Stella-CN/NavBot/docs/README.md

# NavBot 设计文档

更新日期：2026-10-19。已完成资料分析、设计草案及 [navbot_body 工程模板](../deps/navbot_body/README.md)与静态审查；电机闭环、串口协议和 ROS 2 功能尚未实现，未执行固件编译、下载或实机验证。

| 文档 | 内容 |
| --- | --- |
| [C30D硬件分析](c30d-hardware-analysis.md) | 引脚、电机控制、IMU数据流程、证据来源与参数状态 |
| [Jetson与C30D通信协议草案](jetson-c30d-protocol.md) | 系统职责、帧结构、消息内容、时间同步与失效处理 |
| [实施与验证计划](implementation-plan.md) | 技术栈、阶段交付、实测参数清单与验收条件 |

## 参数状态约定

- **用户确认**：用户提供的实车配置；不等于已读取设备或完成测试。
- **资料确认**：原理图或示例源码中已核对；仍需确认实物版本和接线匹配。
- **设计建议**：本项目拟采用的方案，尚未冻结或验证。
- **待实测**：需要在实物或运行系统上测量、读取或标定。
- **待定**：需要在编码前明确的设计细节。

协议 v0.1 为讨论草案，不能作为已经冻结的逐字节实现规范。后续修改应同时维护参数状态和来源。
