Stella-CN/NavBot/docs/implementation-plan.md

# NavBot实施与验证计划

日期：2026-10-19。状态：已完成 navbot_body 工程模板和静态审查，其余功能处于规划阶段。当前授权范围止于模板生成、静态验证及仓库管理，未执行编译、下载或运动测试。

## 1 技术栈与范围

| 层级 | 拟采用技术 | 状态 |
| --- | --- | --- |
| MCU | STM32F407、C、定时器编码器/PWM、UART DMA、ICM20948驱动 | 设计建议 |
| MCU工程框架 | STM32 HAL、CubeF4 V1.28.3、C11、CMake + GCC、VS Code、CMSIS-DAP/OpenOCD | 模板已生成并静态审查；未编译或实测 |
| 调度 | FreeRTOS V10.3.1 / CMSIS-RTOS2，控制、通信、采集、监控四任务 | 静态任务骨架已建立；业务功能和实时性待验证 |
| Jetson | Orin Nano、JetPack 7.2.1、ROS 2 Jazzy | 硬件来自仓库；版本用户确认，待读取设备核对 |
| 主机实现 | C++串口驱动节点、ament/colcon、参数配置 | 设计建议 |
| 定位导航 | robot_localization、SLAM Toolbox或AMCL、Nav2 | 设计建议；具体依赖版本待锁定 |
| 感知 | N10激光雷达、D435深度相机 | 仓库目标架构；实机接口待核对 |

初期由自定义串口节点发布轮式里程计和IMU；不同时叠加另一套运动学控制器。若以后采用ros2_control，应重新明确运动学和TF所有权。

## 2 已确认与待实测参数

| 参数 | 当前状态 | 确认方法 / 输出记录 |
| --- | --- | --- |
| 普通轮四驱差速、MG513 GMR、USB | 用户确认 | 作为方案输入 |
| 新版C30D | 用户确认 | 待读取丝印、记录版本 |
| IMU为ICM20948 | 新版资料确认 | 读取WHO_AM_I、验证通信与轴向 |
| 电机PWM/编码器引脚 | 资料确认 | 与实板、通道接线逐项核对 |
| USB串口3 | 设计建议 | 枚举、稳定身份、拔插与供电测试 |
| 460800/8N1 | 设计建议 | 双向持续传输、错误计数和延迟统计 |
| MG513完整型号及减速比 | 待确认 | 铭牌、订单或厂家规格 |
| 每轮输出轴有效计数 | 待实测 | 标记车轮，多圈正反转计数，核验倍率 |
| A/B/C/D到四轮映射 | 待实测 | 架空单轮点动和手动转轮记录 |
| 电机/编码器符号 | 待实测 | 四轮前进方向均为正，确认闭环负反馈 |
| 实际轮径、左右差异 | 待实测 | 负载下滚动距离标定；85mm模型仅作线索 |
| 几何轮距、轴距 | 待实测 | 装配测量 |
| 有效轮距b_eff | 待标定 | 正反向旋转、多圈、不同地面/载荷验证 |
| 最大轮速与加减速度 | 待实测 | 负载测试、停车距离与驱动能力评估 |
| PI参数 | 待整定 | 各轮阶跃、低速、正反转、负载变化 |
| 电池规格与阈值 | 待确认/实测 | 化学体系、串数、BMS阈值、电压校准及迟滞 |
| IMU外参、偏置和噪声 | 待标定 | 静置、六面、受控旋转和温度变化 |
| 100Hz控制、100Hz反馈 | 设计建议 | 测量真实周期、抖动、传感器新鲜度 |
| 200ms失联阈值 | 设计建议 | 结合最大速度和停车距离确认 |
| 硬件急停/断能路径 | 待确认 | 检查电源链路；PD3仅软件输入 |
| JetPack/ROS版本和内核驱动 | 用户提供，待读取核对 | 软件包版本、系统版本、CH9102枚举 |

所有标定记录应包含日期、板卡/电机标识、固件版本、配置摘要、地面、载荷、测量方法、结果和误差。尚无测量值的单元不得填入示例默认值。

## 3 分阶段实施

### 阶段一 硬件与环境基线

确认板卡、IMU、电机参数、USB端口、供电和轮子接线；读取Jetson环境。明确轮径、计数、方向和电池安全范围。

交付：接线表、参数表、环境清单、测量记录。

验收：每个物理通道可追踪到对应车轮；每轮计数与方向已确认；电源和禁止运动路径明确。

### 阶段二 协议冻结

完成[协议草案](jetson-c30d-protocol.md)第8节待定项；冻结全部消息布局、状态迁移、超时、时间同步、重连和错误处理。MCU框架已选择HAL、CMake/GCC与FreeRTOS，仍需验证工具链和运行行为。

交付：协议v1.0、参数模式、消息黄金样本、状态迁移表、量化测试阈值。

验收：不存在“由实现自行决定”的端序、单位、长度、状态或时效语义；两端可独立按规范实现。

### 阶段三 MCU基础控制

从经过核对的驱动建立最小工程；实现四路编码器、100Hz闭环、IMU、电压、单调时钟、看门狗和安全状态机。按实车整定，删除不使用的巡线、蓝牙抢占和车型切换路径。

交付：固件、参数配置、控制周期和轮速测试记录。

验收：架空方向正确；采集失败不阻塞控制；禁止/故障不会保留旧PI输出；控制周期和执行时间满足冻结指标。

### 阶段四 两端通信

实现定宽编解码、CRC、DMA收发、固定容量队列、握手与会话、时间同步、ACK和诊断。Jetson串口资源采用RAII管理，支持有界退出和重连。

数据所有权：DMA只写接收缓冲，解析器消费完整帧，控制任务拥有执行目标和PI状态；遥测读取一致快照。配置通过明确事务切换，不能在控制中途改变多个相关参数。实时路径避免动态分配和阻塞I/O。

交付：两端通信、黄金向量测试、错误注入记录。

验收：拆包、粘包、CRC错、超长、未知ID、序号回绕、旧会话、延迟命令、USB断连、MCU重启均符合协议；无越界和无界缓存增长。

### 阶段五 ROS与标定

发布轮式里程计、IMU和诊断；完成采样时间到ROS时间映射。建立URDF固定外参，配置EKF，验证唯一TF发布者。标定轮径、有效轮距、IMU偏置与协方差。

交付：ROS包、启动与参数文件、标定记录、rosbag。

验收：前进vx为正，左转wz为正；计数重启不造成位姿突跳；同源数据不被当作独立观测重复融合；直行、旋转误差满足冻结阈值。

### 阶段六 导航与故障联调

接入激光定位和Nav2，先低速、再逐级验证目标运行范围。D435与N10直接接入Jetson，其数据不通过底盘串口转发。

交付：导航配置、运行手册、故障矩阵与持续运行报告。

验收：停止上游cmd_vel、终止串口节点、拔USB、MCU复位、IMU异常、欠压等场景均按规定停车或禁止；恢复后不自动继续旧运动。记录停车时间和距离，不能仅以“PWM已清零”作为验收。

## 4 测试原则

- 先架空单轮，再架空闭环，最后落地低速；运动测试需在实施阶段另行安排。
- 根据实测冻结控制抖动、通信延迟、同步误差、里程计误差和停车距离阈值，不宣称当前已达标。
- 测试覆盖输入边界与失效行为，不只测试正常报文和直线行驶。
- 软件STOP、驱动制动与硬件断能分别验证。
- 未验证的电流、荷电百分比、绝对航向等不作为功能交付。

当前交付包含本组设计文档及 [navbot_body 工程模板](../deps/navbot_body/README.md)，通过 submodule 管理。模板仅完成静态审查，未编译或下载；未实现闭环、ROS节点或可执行协议。
