Stella-CN/NavBot/hardware/5寸屏幕-2D-B/2D.png

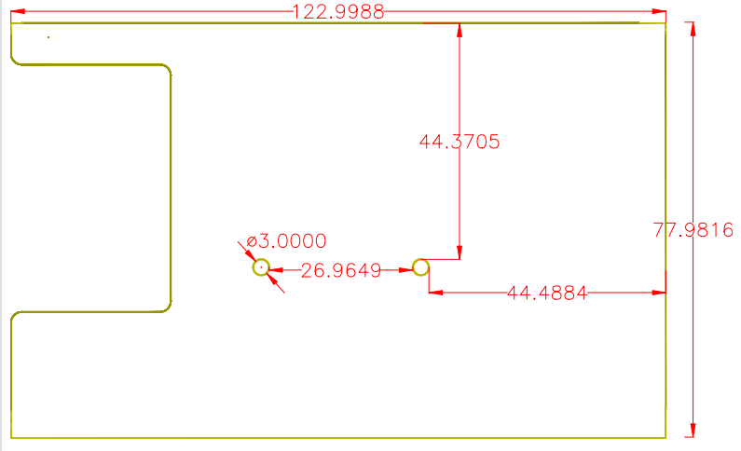
hardware/5寸屏幕-2D-B/2D.png
