Stella-CN/NavBot/hardware/12v-19v变压器图纸.png

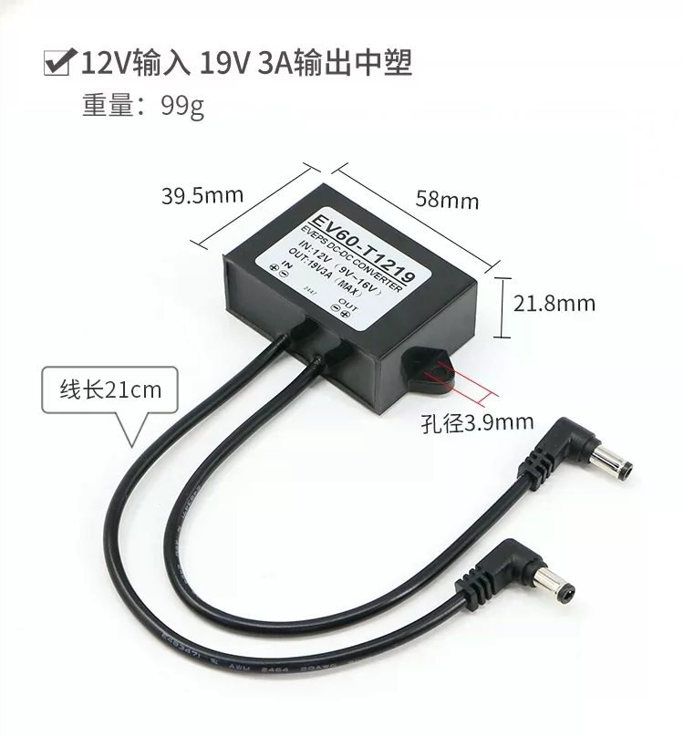
hardware/12v-19v变压器图纸.png
