Stella-CN/NavBot/hardware/开关图纸.png

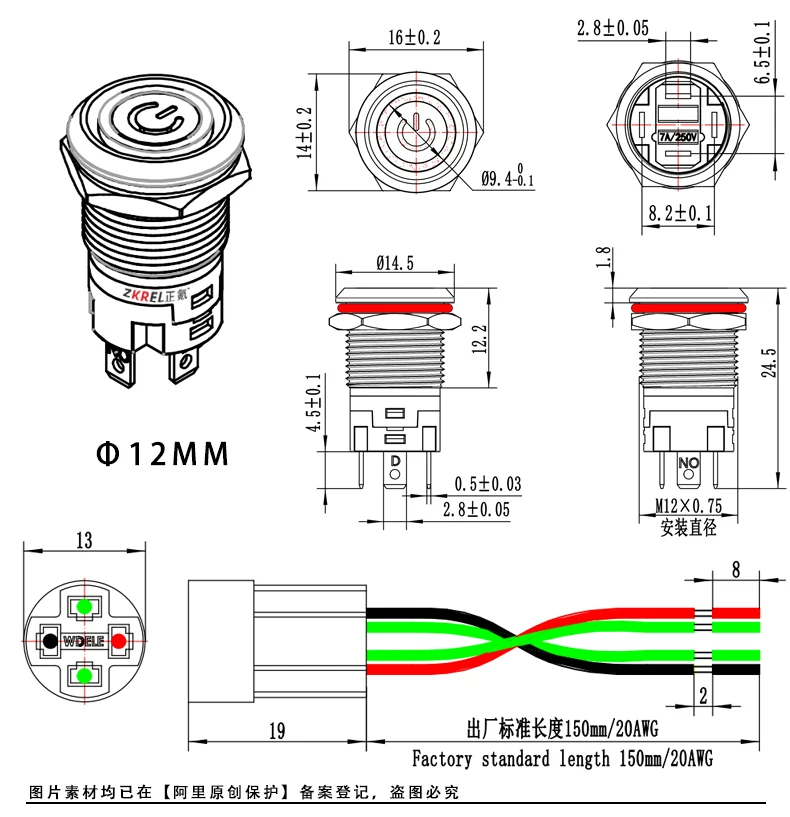
hardware/开关图纸.png
