Stella-CN/NavBot/hardware/design-v13/打印件清单.csv

编号 | 名称 | 数量 | CAD对象 | STL
01 | 承重底板（直连金属支架） | 1 | ChassisLower | prototype-stl/ChassisLower.stl
02 | 整体罩壳＋颈部过渡 | 1 | ChassisLid | prototype-stl/ChassisLid.stl
03 | 后抽充电座＋线夹鞍座 | 1 | ChargePort_Insert_D12_placeholder | prototype-stl/ChargePort_Insert_D12_placeholder.stl
04 | 双螺丝鞍式线夹压盖 | 1 | ChargeCableClampCap | prototype-stl/ChargeCableClampCap.stl
05 | 上压架＋C30D 安装台＋M3螺母耳 | 1 | C30D_RemovableTray | prototype-stl/C30D_RemovableTray.stl
06 | 升压模块四点框架 | 1 | DCDC_RemovableTray | prototype-stl/DCDC_RemovableTray.stl
07 | 头部前壳＋面板＋屏幕/相机托架 | 1 | HeadFront | prototype-stl/HeadFront.stl
08 | 曲面主壳＋N10齐平安装面及穿线孔 | 1 | HeadRear | prototype-stl/HeadRear.stl
09 | Jetson 可拆托盘 | 1 | Jetson_RemovableTray | prototype-stl/Jetson_RemovableTray.stl
10 | 电池下托＋共用安装耳 | 1 | BatteryTray_strap_slots | prototype-stl/BatteryTray_strap_slots.stl
