Stella-CN/NavBot/hardware/5寸屏幕-2D-B/GKHD5.0-2D.dxf

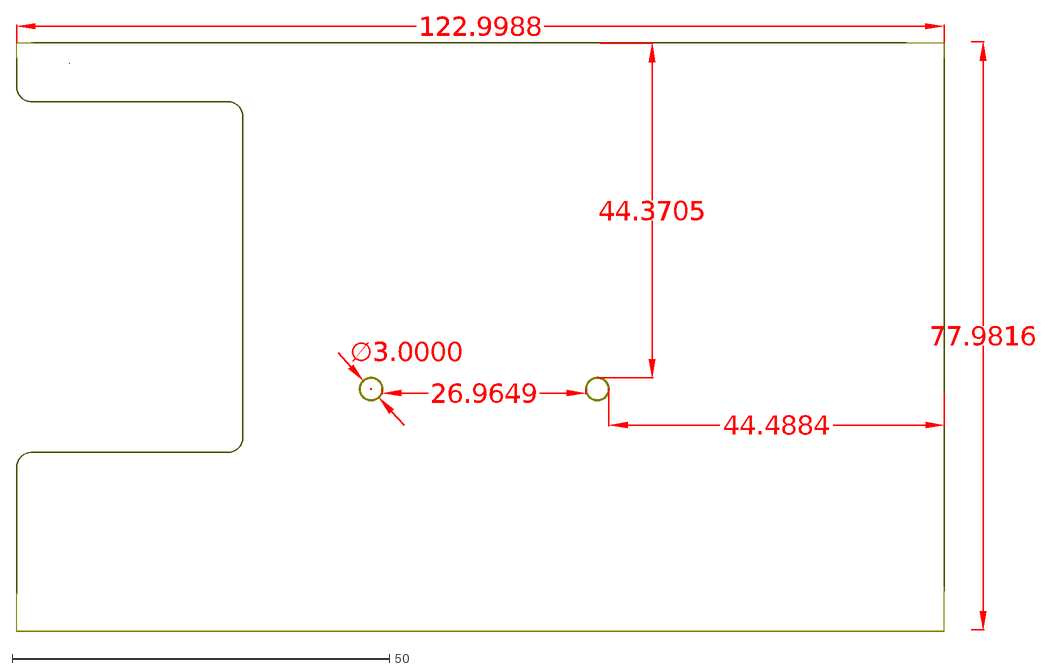
[picture p6: CAD file, 2026-10-19]
hardware/5寸屏幕-2D-B/GKHD5.0-2D.dxf
122.9988
77.9816
44.4884
44.3705
26.9649
∅3.0000
