Stella-CN/NavBot/hardware/Depth-Cameras/D456_Solid.SLDPRT

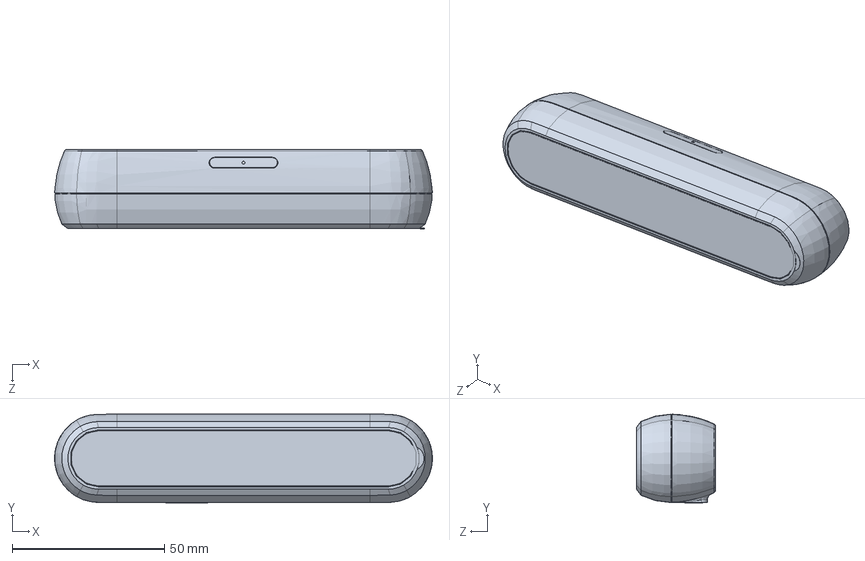
[picture p7: CAD file, 2026-10-19]
hardware/Depth-Cameras/D456_Solid.SLDPRT
124.0 x 29.1 x 26.0 mm
