Stella-CN/NavBot/hardware/design-v13/NavBot-V13-Print-Pack/STEP/10_BatteryTray_strap_slots.step

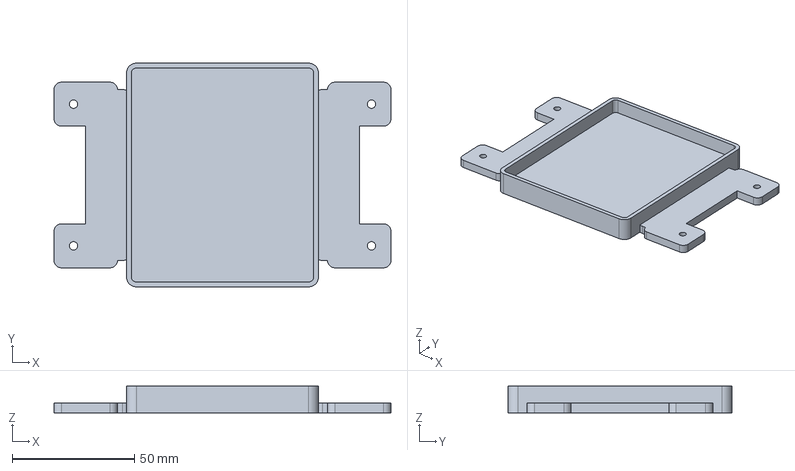
[picture p8: CAD file, 2026-10-19]
hardware/design-v13/NavBot-V13-Print-Pack/STEP/10_BatteryTray_strap_slots.step
138.0 x 91.6 x 11.0 mm
