Stella-CN/NavBot/hardware/design-v13/prototype-stl/ChassisLid.stl

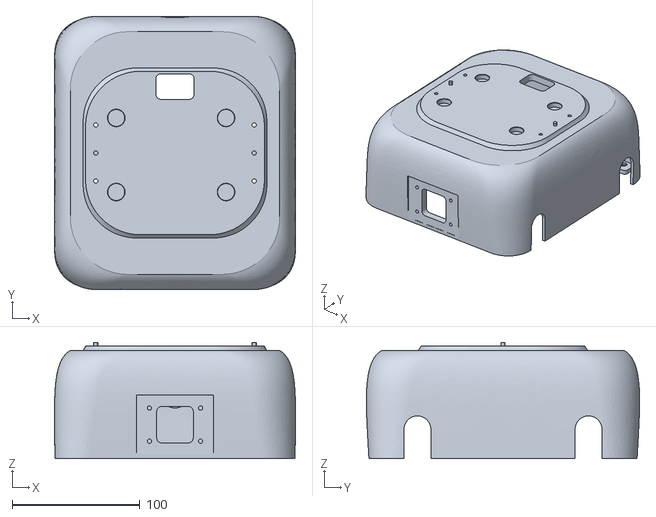
[picture p9: CAD file, 2026-10-19]
hardware/design-v13/prototype-stl/ChassisLid.stl
188.7 x 214.0 x 91.2
