Stella-CN/NavBot/hardware/STM32主控-C10B（两驱差速车使用）.stp

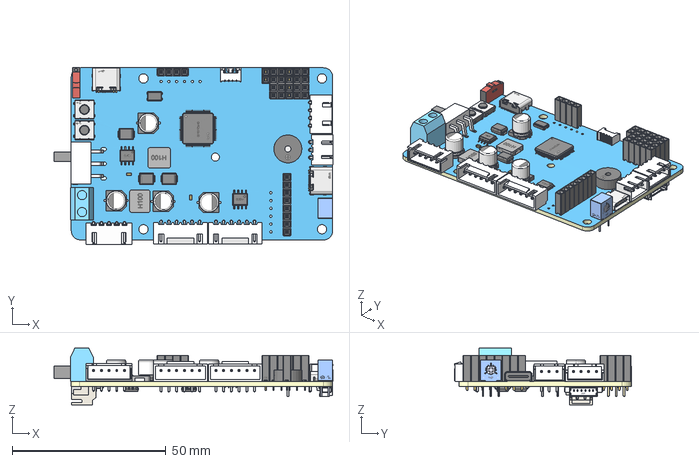
[picture p10: CAD file, 2026-10-19]
hardware/STM32主控-C10B（两驱差速车使用）.stp
90.7 x 57.6 x 18.5 mm
