Stella-CN/NavBot/hardware/Depth-Cameras/D435_Solid.SLDPRT

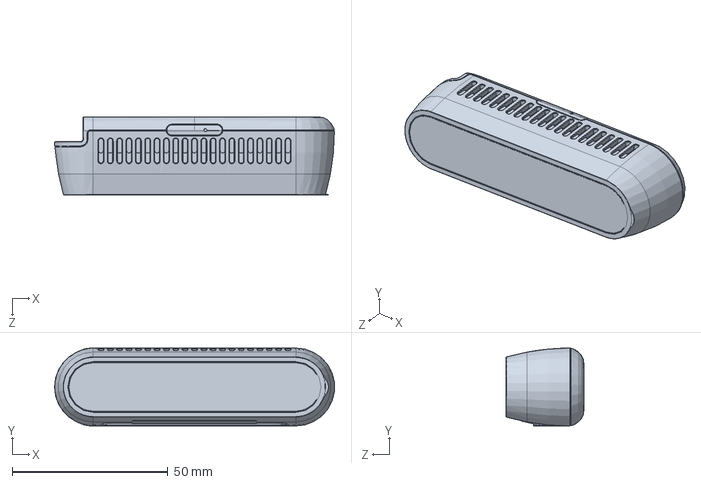
[picture p11: CAD file, 2026-10-19]
hardware/Depth-Cameras/D435_Solid.SLDPRT
89.8 x 25.0 x 25.1 mm
