Stella-CN/NavBot/hardware/design-v13/NavBot-V13-Print-Pack/STEP/03_ChargePort_Insert_D12_placeholder.step

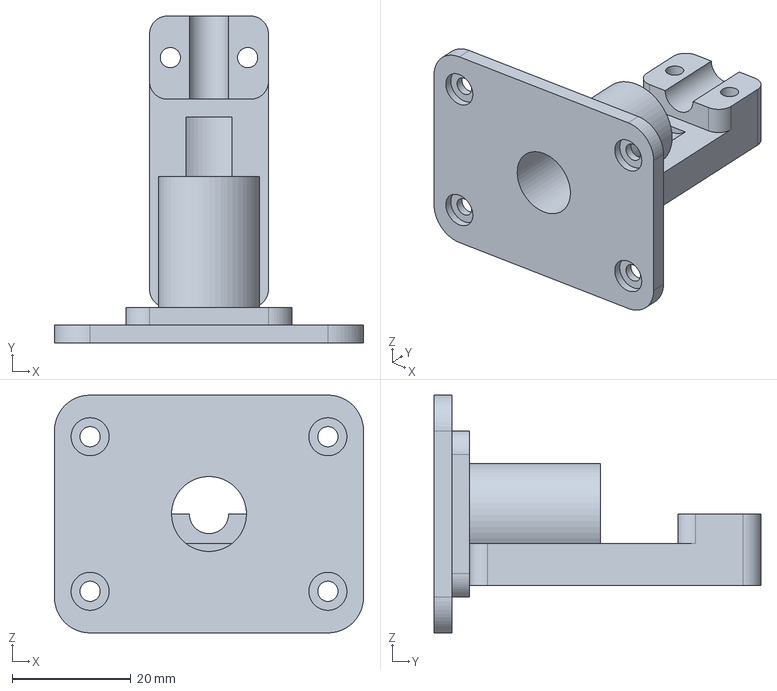
[picture p12: CAD file, 2026-10-19]
hardware/design-v13/NavBot-V13-Print-Pack/STEP/03_ChargePort_Insert_D12_placeholder.step
52.0 x 55.0 x 40.0 mm
