Stella-CN/NavBot/hardware/design-v13/prototype-stl/HeadFront.stl

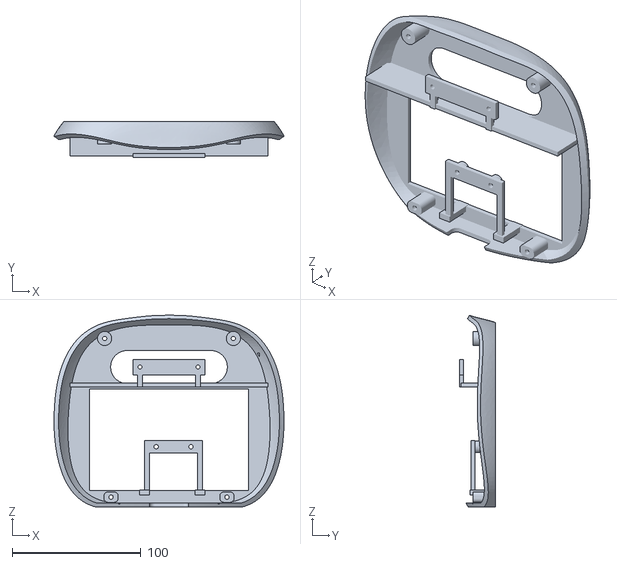
[picture p13: CAD file, 2026-10-19]
hardware/design-v13/prototype-stl/HeadFront.stl
178.6 x 28.0 x 148.7
