Stella-CN/NavBot/hardware/雷达_雷神N10.stp

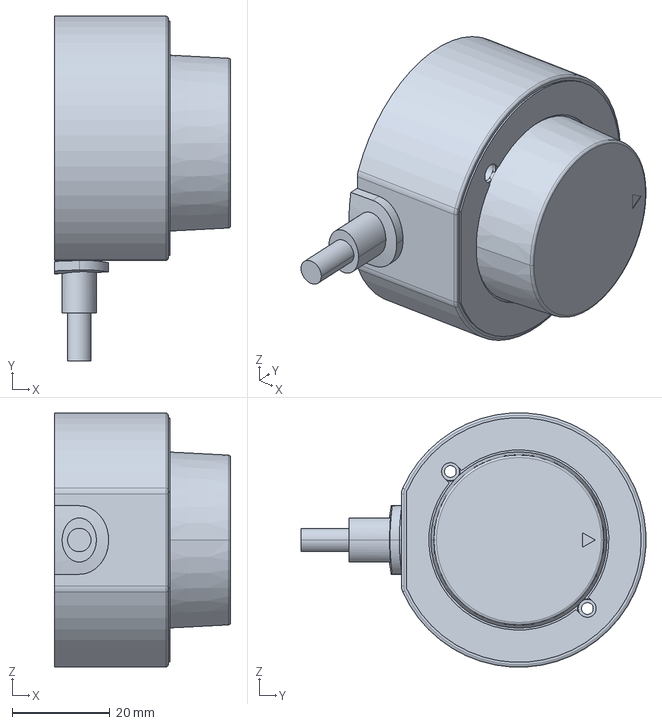
[picture p14: CAD file, 2026-10-19]
hardware/雷达_雷神N10.stp
36.1 x 70.5 x 51.9 mm
