Stella-CN/NavBot/hardware/design-v13/NavBot-V13-Print-Pack/STEP/09_Jetson_RemovableTray.step

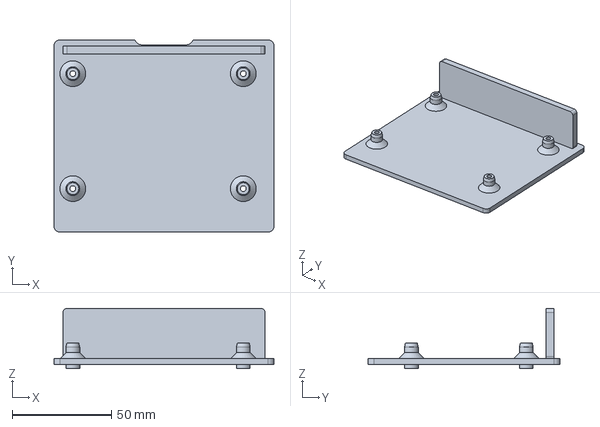
[picture p15: CAD file, 2026-10-19]
hardware/design-v13/NavBot-V13-Print-Pack/STEP/09_Jetson_RemovableTray.step
111.0 x 97.0 x 30.3 mm
