Stella-CN/NavBot/hardware/design-v13/prototype-stl/HeadRear.stl

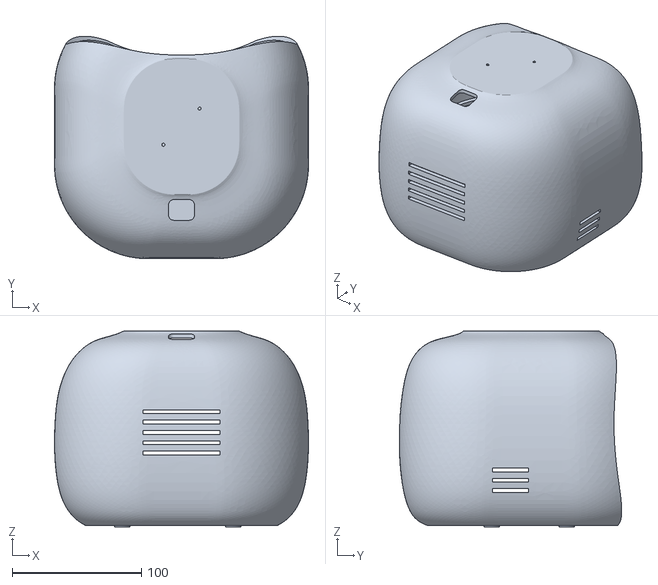
[picture p16: CAD file, 2026-10-19]
hardware/design-v13/prototype-stl/HeadRear.stl
196.7 x 172.3 x 151.7
