Stella-CN/NavBot/hardware/E351S电池(客户图）.stp

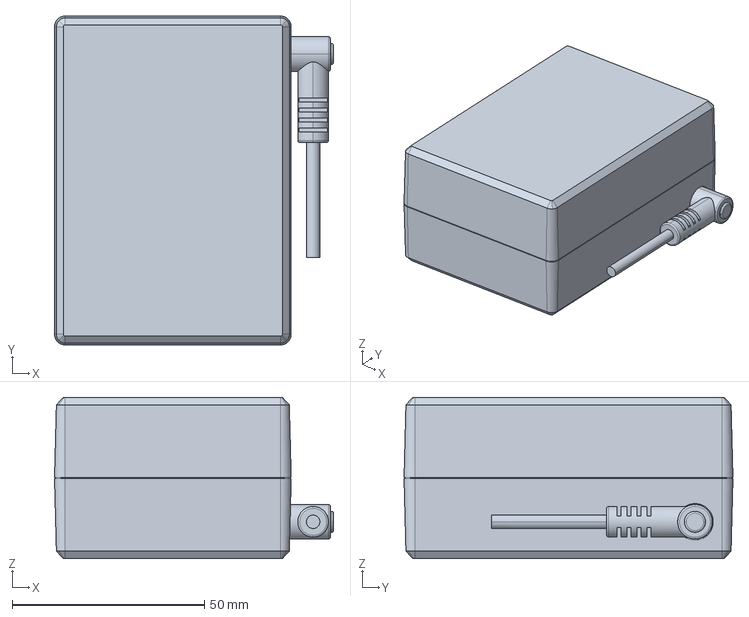
[picture p17: CAD file, 2026-10-19]
hardware/E351S电池(客户图）.stp
72.6 x 85.6 x 42.0 mm
