Stella-CN/NavBot/hardware/design-v13/NavBot-V13-Print-Pack/STEP/05_C30D_RemovableTray.step

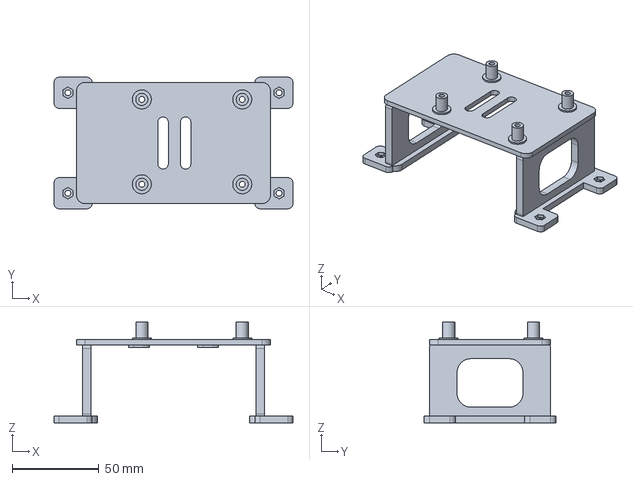
[picture p18: CAD file, 2026-10-19]
hardware/design-v13/NavBot-V13-Print-Pack/STEP/05_C30D_RemovableTray.step
138.0 x 76.0 x 58.1 mm
