Stella-CN/NavBot/hardware/轴直径6mm_六角联轴器.stp

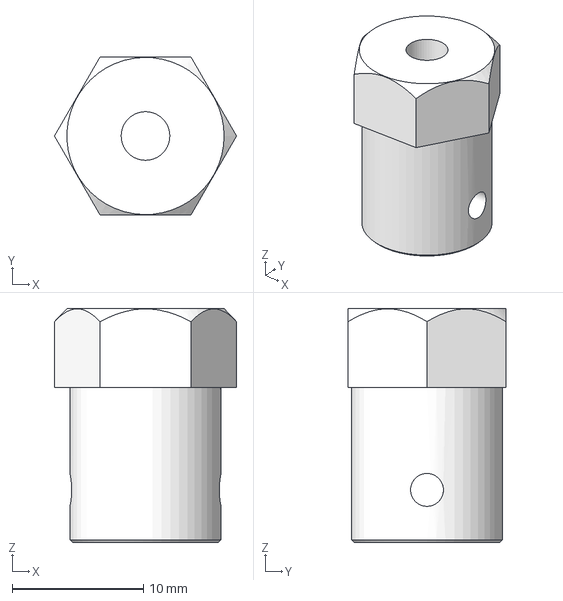
[picture p19: CAD file, 2026-10-19]
hardware/轴直径6mm_六角联轴器.stp
13.9 x 12.0 x 17.8 mm
