Stella-CN/NavBot/hardware/Depth-Cameras/D415_Solid.SLDPRT

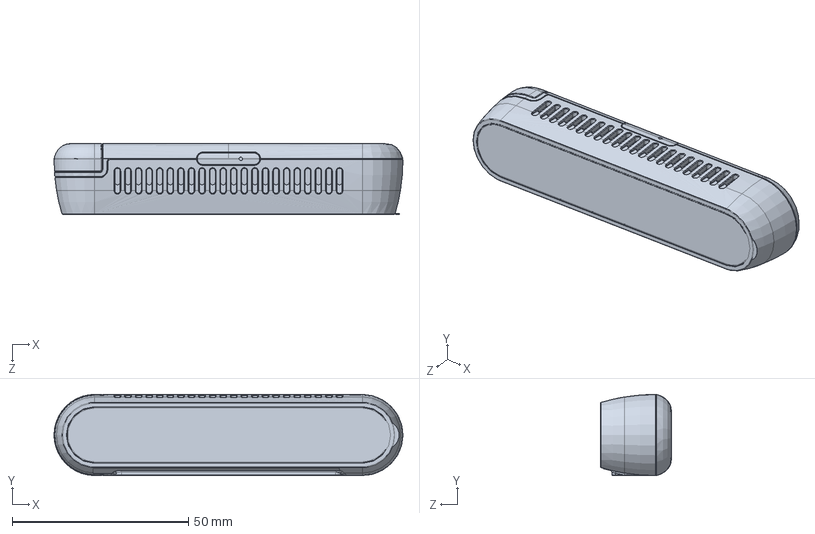
[picture p20: CAD file, 2026-10-19]
hardware/Depth-Cameras/D415_Solid.SLDPRT
99.0 x 23.0 x 20.1 mm
