Stella-CN/NavBot/hardware/design-v13/prototype-stl/DCDC_RemovableTray.stl

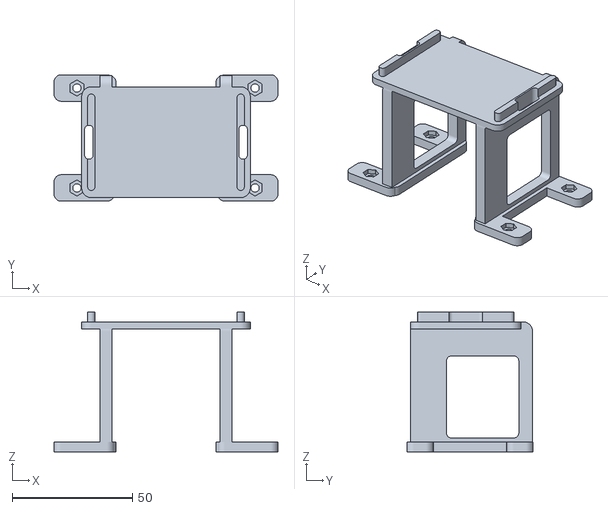
[picture p21: CAD file, 2026-10-19]
hardware/design-v13/prototype-stl/DCDC_RemovableTray.stl
93.0 x 52.5 x 58.0
