Stella-CN/NavBot/hardware/STM32主控-C30D（小车使用）.stp

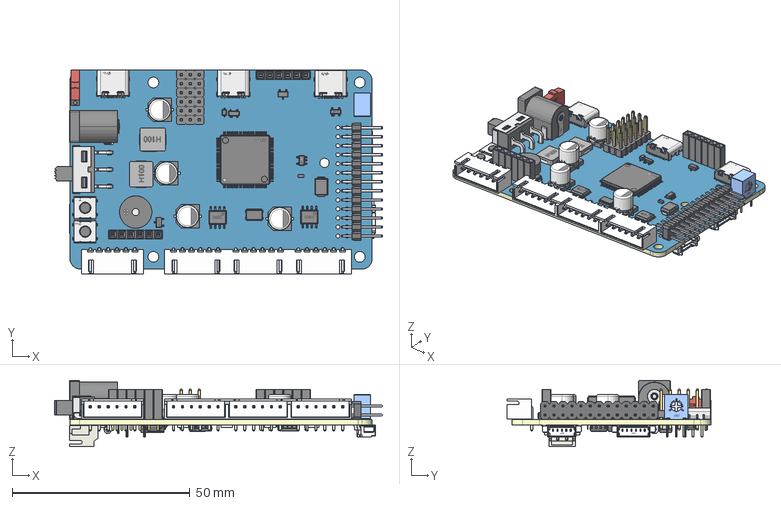
[picture p22: CAD file, 2026-10-19]
hardware/STM32主控-C30D（小车使用）.stp
92.2 x 57.5 x 18.7 mm
