Stella-CN/NavBot/hardware/Depth-Cameras/D405_Solid.SLDPRT

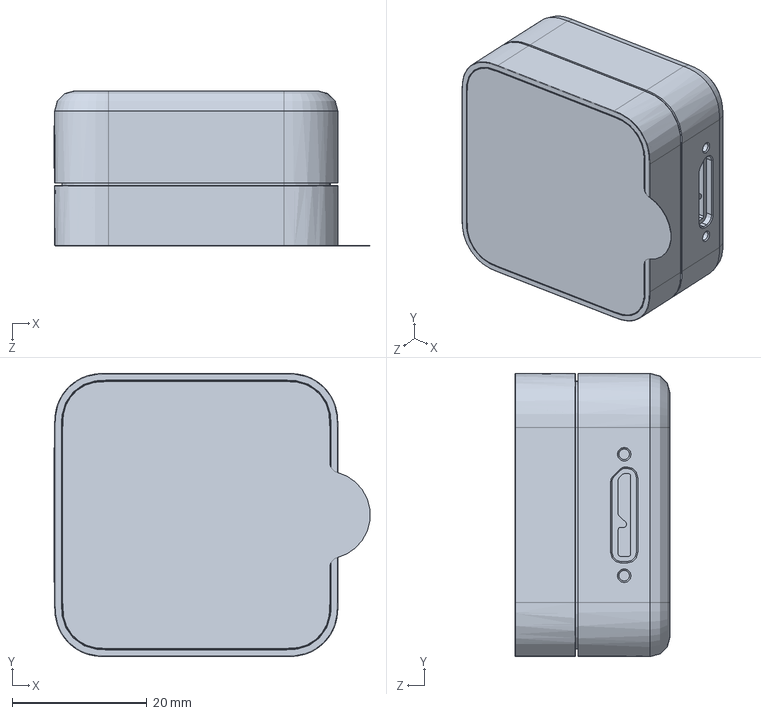
[picture p23: CAD file, 2026-10-19]
hardware/Depth-Cameras/D405_Solid.SLDPRT
46.8 x 42.0 x 23.0 mm
