Stella-CN/NavBot/hardware/design-v13/NavBot-V13-Print-Pack/STEP/04_ChargeCableClampCap.step

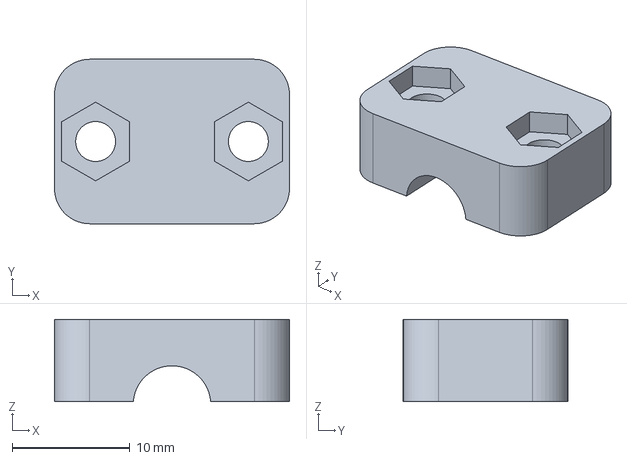
[picture p24: CAD file, 2026-10-19]
hardware/design-v13/NavBot-V13-Print-Pack/STEP/04_ChargeCableClampCap.step
20.0 x 14.0 x 7.00 mm
