Stella-CN/NavBot/hardware/design-v13/prototype-stl/ChassisLower.stl

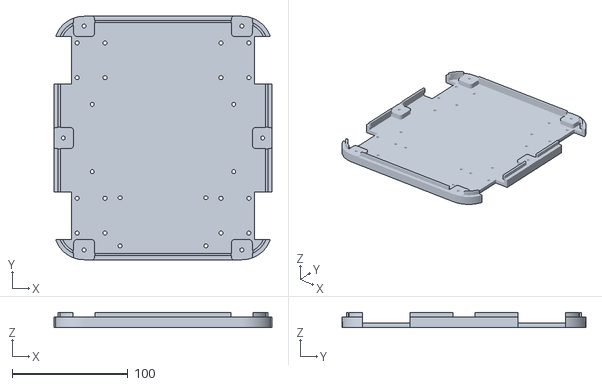
[picture p25: CAD file, 2026-10-19]
hardware/design-v13/prototype-stl/ChassisLower.stl
188.0 x 210.0 x 13.0
