Stella-CN/NavBot/hardware/电机支架_MG513电机支架(37支架）.stp

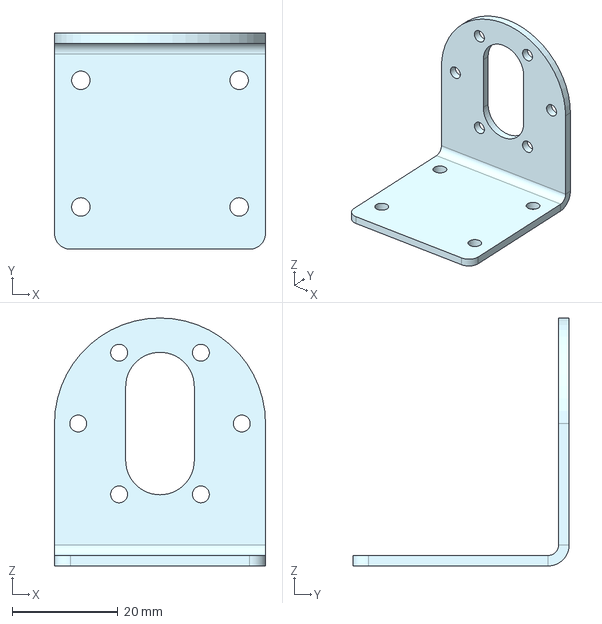
[picture p26: CAD file, 2026-10-19]
hardware/电机支架_MG513电机支架(37支架）.stp
40.0 x 41.0 x 47.0 mm
