Stella-CN/NavBot/hardware/Depth-Cameras/D455f_Solid.SLDPRT

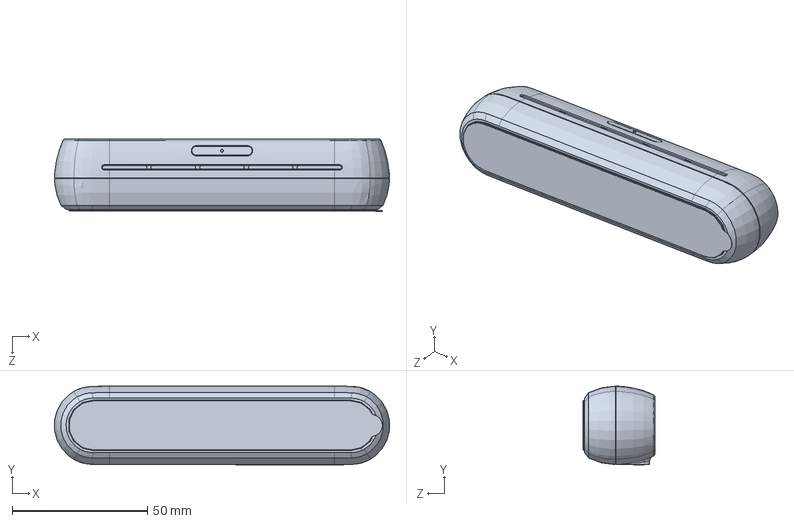
[picture p27: CAD file, 2026-10-19]
hardware/Depth-Cameras/D455f_Solid.SLDPRT
123.8 x 29.1 x 26.6 mm
