Stella-CN/NavBot/hardware/直流电机_MG513P10-12V(GMR）.stp

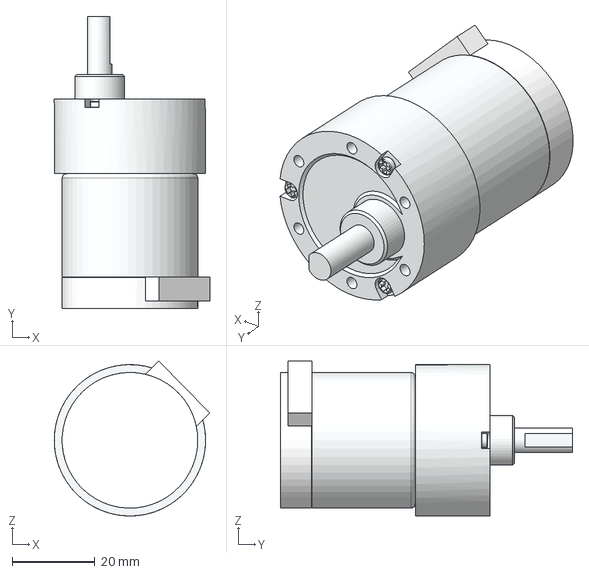
[picture p28: CAD file, 2026-10-19]
hardware/直流电机_MG513P10-12V(GMR）.stp
37.6 x 70.6 x 37.5 mm
