Stella-CN/NavBot/hardware/Depth-Cameras/D435f_Solid.SLDPRT

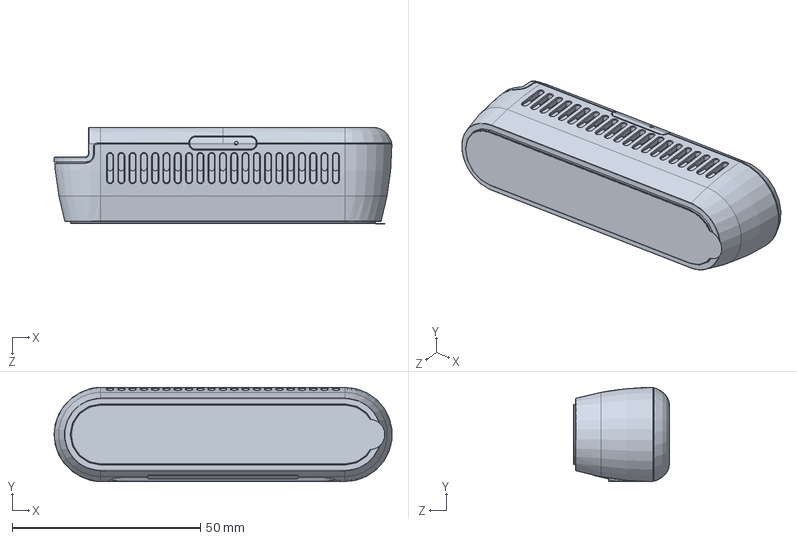
[picture p29: CAD file, 2026-10-19]
hardware/Depth-Cameras/D435f_Solid.SLDPRT
89.8 x 25.0 x 25.6 mm
