Stella-CN/NavBot/hardware/Depth-Cameras/D457_Solid.SLDPRT

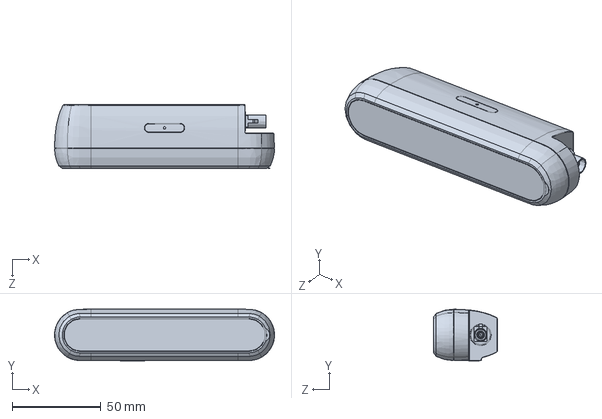
[picture p30: CAD file, 2026-10-19]
hardware/Depth-Cameras/D457_Solid.SLDPRT
124.0 x 29.1 x 36.0 mm
