Stella-CN/NavBot/hardware/智能车轮_直径85mm.stp

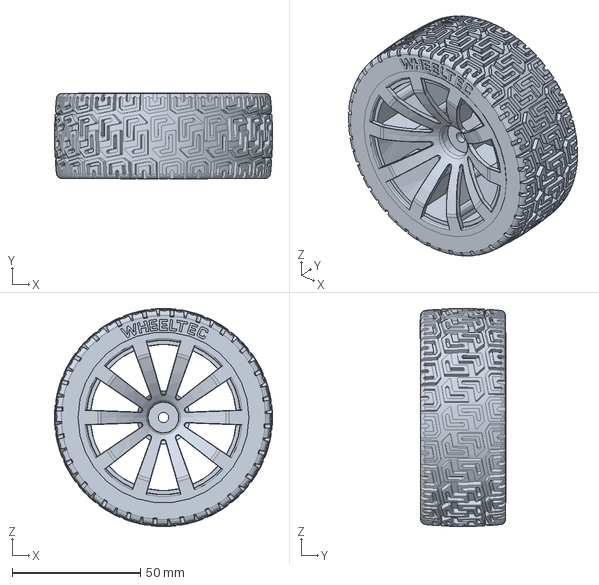
[picture p31: CAD file, 2026-10-19]
hardware/智能车轮_直径85mm.stp
85.0 x 33.4 x 85.0 mm
