Stella-CN/NavBot/(list of files, cad)

Other CAD files:
hardware/design-v13/NavBot-V13.FCStd
hardware/Depth-Cameras/D435i_Solid.SLDPRT
hardware/Depth-Cameras/D455_Solid.SLDPRT
hardware/design-v13/prototype-stl/BatteryTray_strap_slots.stl
hardware/design-v13/NavBot-V13-Print-Pack/STEP/02_ChassisLid.step
hardware/design-v13/NavBot-V13-Print-Pack/STEP/01_ChassisLower.step
hardware/design-v13/prototype-stl/C30D_RemovableTray.stl
hardware/design-v13/NavBot-V13-Print-Pack/STEP/06_DCDC_RemovableTray.step
hardware/design-v13/prototype-stl/Jetson_RemovableTray.stl
hardware/P3766-P3768SKU4-P3767ENVELOPE.stp
hardware/design-v13/NavBot-V13-Print-Pack/STEP/08_HeadRear.step
hardware/design-v13/prototype-stl/ChargePort_Insert_D12_placeholder.stl
hardware/design-v13/NavBot-V13-Print-Pack/STEP/07_HeadFront.step
hardware/design-v13/prototype-stl/ChargeCableClampCap.stl
hardware/design-v13/NavBot-V13-Print-Pack/STL/01_ChassisLower.stl
hardware/design-v13/NavBot-V13-Print-Pack/STL/02_ChassisLid.stl
hardware/design-v13/NavBot-V13-Print-Pack/STL/03_ChargePort_Insert_D12_placeholder.stl
hardware/design-v13/NavBot-V13-Print-Pack/STL/04_ChargeCableClampCap.stl
hardware/design-v13/NavBot-V13-Print-Pack/STL/05_C30D_RemovableTray.stl
hardware/design-v13/NavBot-V13-Print-Pack/STL/06_DCDC_RemovableTray.stl
hardware/design-v13/NavBot-V13-Print-Pack/STL/07_HeadFront.stl
hardware/design-v13/NavBot-V13-Print-Pack/STL/08_HeadRear.stl
hardware/design-v13/NavBot-V13-Print-Pack/STL/09_Jetson_RemovableTray.stl
hardware/design-v13/NavBot-V13-Print-Pack/STL/10_BatteryTray_strap_slots.stl
