Stella-CN/NavBot/hardware/5寸屏幕-2D-B/GKHD5.0-2D.pdf

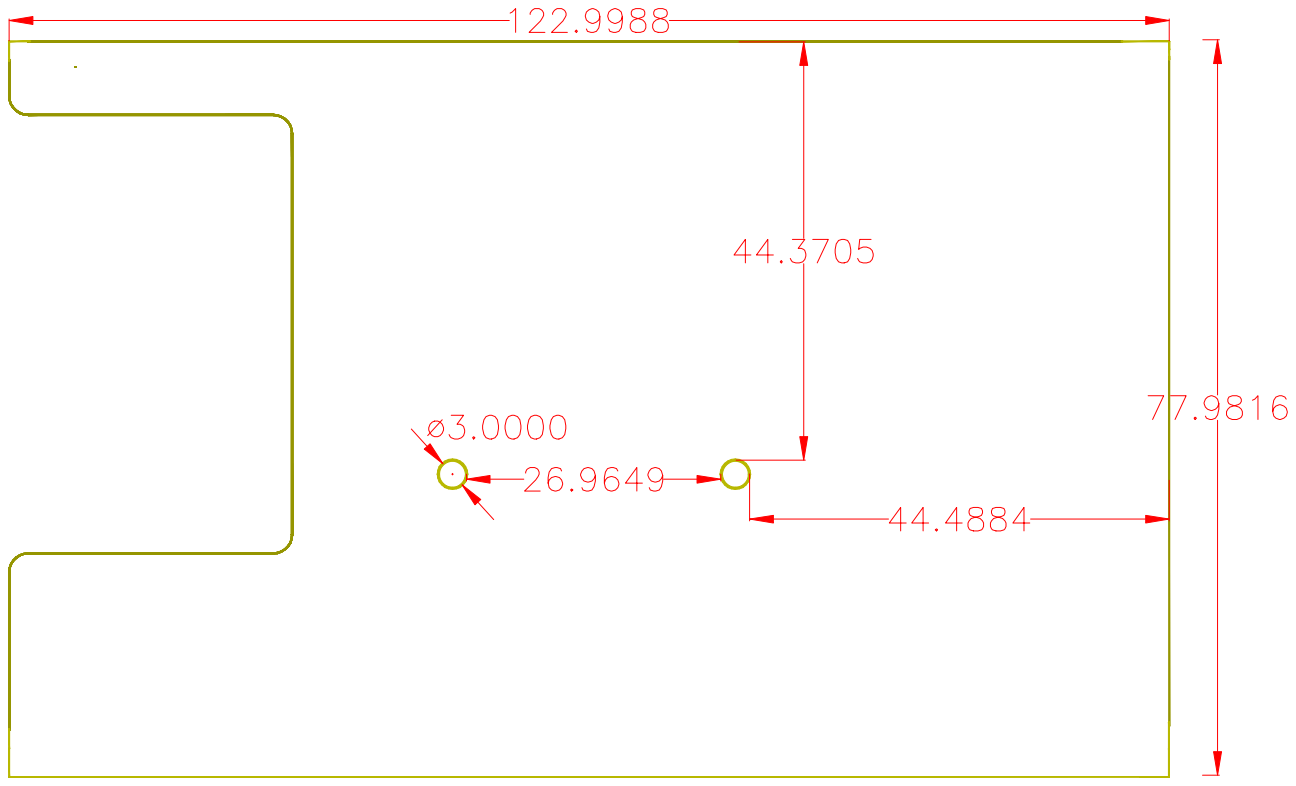
[picture p41: page 1]
