Stella-CN/NavBot/hardware/design-v13/NavBot-V13-Print-Pack/FDM打印说明.txt

NavBot V13 / PETG FDM打印与装配
适用：220×220mm平台；0.4mm喷嘴作为起始工艺假设。尺寸单位mm。最大平面尺寸约214mm，220mm平台使用裙边/宽brim时须核对总占地，不能默认再加宽brim仍可放下。

结构改动
- 结构耳板厚4，M3六角槽对边5.8、深2，槽底2；Ø3.4通孔。螺母允许露出0.4。
- 底盘6处宽根耳板名义18×18，边角R3并与曲面外壳相交；底板增加直接承压台，定位止口局部让位。四角轴线X±68、Y±96.5，两侧X±86、Y0；6颗M3×12。
- 前后头壳连接不再用分缝裁切螺母座，清除旧定位舌与窄柱，重新布置完整承压耳、侧筋及工具入口。
- Jetson四柱统一采用连续柱体：柱身Ø7、顶部2mm渐缩至Ø6、根部Ø13、通孔Ø2.9；无侧切或外伸桥。天线固定座为厚4mm的连续壁，与托盘一体相连，取消四根独立支腿及悬空横跨。头部底板承压座同步为Ø12，底盘上盖让位孔Ø13.2并设入口倒角。
- 前壳四柱为连续实心几何，仅保留通孔与头部沉孔；后壳四耳通过宽根部与壳壁相连。切片时这些柱体和耳根设置局部100%填充，CAD实体本身不能代替切片填充设置。
- 电池/C30D与DC/DC使用外露耳板，金属电机支架直接连接底板。不增加单独打印支架或金属限压套管。

切片起始设置（需按实际PETG与打印机校准）
0.20层高；4～5圈外壁；顶底实体厚度至少1.2；一般填充25～35%；安装耳、承压台和支柱用局部100%填充修改器。
这不是已完成试打的认证参数。PETG打印温度和冷却按所用材料及设备配置，不直接套用未知温度。

10个打印件的方向和支撑重点
01 底板：底面朝平台；检查底部螺丝头凹槽桥接质量，清理凹槽后再装螺丝。
02 底盘罩壳：开口朝上、顶部向下倾放或按切片器选择接触面；曲面顶部需要可移除支撑，保护外观面。六角槽、贯穿孔和定位止口不得留支撑残料。六处耳板下方需局部支撑，不能默认整壳无支撑打印。
03 充电座：按能接触平台的最大平面定向，长孔与线夹悬臂使用局部支撑；接口内孔清理后试装实物。
04 线夹压盖：平整承压面向下，螺母槽朝上；线缆弧槽按切片预览决定桥接/局部支撑。
05 C30D托架：上平台朝下、外伸脚朝上可减少大平台桥接；PCB支柱接触平台时补局部支撑。不要让支撑封住底部PCB螺母槽。装配前确认所有脚面共面。
06 DC/DC托架：上平台朝下、四耳朝上；导轨、绑带槽周围安排局部支撑，清理后试穿绑带。
07 头部前壳：前面板平面朝下，保护可见面；相机/屏幕内托架、连接耳和侧筋需要局部支撑，可从开放后侧拆除。
08 头部后壳：底部朝下，前侧开口用于清理内部支撑；底部局部凸台、悬伸耳和头顶内表面使用可拆支撑。不得将螺母打印封死。
09 Jetson托盘：大平板朝下，底部短支柱使大平板悬空2mm，需设置可移除支撑；天线固定壁由托盘直接向上生长，无悬空横跨。螺孔保持畅通，支柱顶面清理平整。
10 电池仓：底面朝下，安装耳槽朝上；检查绑带槽与底面平整度。
导出的STL仅按装配坐标居中、落到Z0，未自动旋转成上述建议方向，也不包含支撑。

打印前必须查看切片预览：耳根、槽底与壳壁是否为连续实体；避免小岛、悬空起印、单线承重区域；支撑须可从开口取出。孔和六角槽先打印尺寸试片，再批量打印。M3槽AF5.8是建模间隙，不保证任意机器无需校准即可装入。
保留螺丝+可取出螺母，不用自攻螺丝。M3以外必要例外：Jetson原孔用M2.5、N10用M2、采购件原生金属螺纹和开关锁紧螺母保留。
模型有效性、干涉和闭合网格检查不能替代切片验证、实物载荷、螺丝预紧及PETG长期蠕变试验。
参考：Prusa Modeling with 3D printing in mind
https://help.prusa3d.com/article/modeling-with-3d-printing-in-mind_164135
