Stella-CN/NavBot/hardware/design-v13/NavBot-V13-Print-Pack/WiFi天线改装说明.txt

V13 Wi-Fi天线重新布置
两片原装48×11×0.8mm天线片竖直并排安装于托盘前缘。背面与打印固定面留0.5mm，使用绝缘双面胶固定，不夹压射频接点；安装面背靠天线无器件一侧。不得使用金属胶带。打印件仍为10件。
四个PCB支柱统一：柱身直径7mm，顶部2mm渐缩到直径6mm，根部直径13mm，中心直径2.9mm通孔；M2.5×20及原底部螺母位置不变，无侧向切口。
同轴线按原模型直径1.13mm规划，右88.15mm、左91.22mm；原模型估算长度约99.62、99.21mm。余量分别约11.47、7.99mm，安装时在板底留自然松弛弧线，不拉扯微型接头。规划最小弯曲半径约3.92mm，不是线材厂家认证值；实物线长、护套及弯曲要求需核对。可用绝缘胶带固定板底走线，接头附近不施加拉力。
天线随Jetson托盘整体维护，先拆前脸、断开外接线并卸下贯穿螺钉，再抬起12mm并向前取出。
使用实际STEP天线几何，无缩放；原文件左侧重合备选天线几何不重复装配。原始采购件模型保存在hardware目录。
模型静态及拆装检查只验证几何，不等于射频性能或PETG长期载荷验证。无线信号质量需整机实测。
参考：NVIDIA原装天线脱离底托说明 https://forums.developer.nvidia.com/t/mounting-jetson-orin-nano-developer-kit/353681

固定座更新：四根支腿与重叠背板已合并为4mm连续壁，粘贴面Y37.3及天线位置不变。修改以当前NavBot-V13.FCStd为准。
