Stella-CN/NavBot/hardware/design-v13/NavBot-V13-Print-Pack/充电口优化说明.txt

V13 充电口嵌件局部优化
原对象名及安装坐标保持不变。法兰、定位止口、四处M3固定孔及两处线夹M3孔不变。
套筒下方改为连续7mm底梁；线夹改为12mm高连续实体，取消小空腔、侧壁叠加和废弃顶丝凸台。
母头内径12.6mm，线槽直径6.6mm；母头仍为待实测包络，需软衬垫配合线夹压盖。
CAD面数76降至52。实体体积增加约12.7%，用于填平不必要空隙，不代表实际切片耗材同比增加。
具体校核见charge-simplification-checks.json和charge-access-checks.json。参考图/ CAD-charge-after.png为本次更新；装配及加工以当前模型为准。
