Stella-CN/NavBot/hardware/design-v13/NavBot-V13-Print-Pack/设计与装配说明.txt

NavBot V13 — 现阶段冻结工程基准（2026-10-19）
单位：mm；材料：PETG；本文件配合本版FCStd、STL、STEP使用。

1. 已确认设计
05 C30D承重托架、06 DC/DC托架的四处安装耳向外伸出。耳板厚4，六角槽深2，槽底厚2。M3槽对边5.8，通孔3.4；M3螺母名义对边5.5、厚2.4，上露约0.4，允许外露。
05孔距122×58；06孔距74×41.5。01底板、10电池仓孔位同步修改，所有打印件须使用本包配套版本。取消金属限压套管及长贯穿立柱。
05连接叠层：底部螺丝头—0.5垫片—4底板—4电池仓法兰—2耳板槽底—M3螺母。M3x14穿过螺母后露出约1.1。
06连接叠层：底部螺丝头—0.5垫片—4底板—2耳板槽底—M3螺母。M3x10穿过螺母后露出约1.1。
电池夹持高度及1.5软垫位置保留；安装耳与电池仓形成硬限位，不能靠拧紧螺丝压缩电池。

2. 头部连接重构
旧曲面分缝切入螺丝座，造成孔边薄壁、尖角残片。已移除旧座并恢复局部壳面，重新建立平面圆角安装耳。
前后壳4处：后壳14×14×4圆角耳板、前壳上方直径11×4圆耳、下方11×8×4圆角耳，六角槽深2，对边5.8；前后承接面间隙0.4。耳根与壳壁连接，前壳四处改为从承接面连续连接到前面板的实心柱，仅保留螺丝孔与头部沉孔。后壳耳根补为宽实体根部并增加背部连接加强。
曲面分缝不再参与切割六角槽承压环。螺母槽周围检查1mm连续材料带，孔周检查2mm厚连续承压环。上部两孔移至X±50；下部移至X±45、Z115.7。四处统一M3x22。
颈座4处同样改为14×14×4圆角承压耳，上开2mm深六角槽，沿用X±62/Y±22共轴孔。

底盘上盖—底板：6处名义18×18×4宽根耳板；底板直接承压台与定位止口同步调整。四角孔从Y±99.5内移至±96.5；X±68不变，两侧X±86/Y0。上方留螺母装入通道。6颗M3x12。

3. 连接清单（采购长度均指螺丝头下长度）
底板—包围罩壳：6 x M3x12；M3 AF5.5 x 2.4。18×18宽根耳板，厚4；上开六角槽深2；底板同步设置承压台及定位止口避让，从底部装螺丝。
头部前壳—后壳：4 x M3x22；M3 AF5.5 x 2.4。前壳为连续实心柱（保留通孔），后壳4mm耳板＋宽耳根及加强连接，六角槽深2。
头部—底盘颈座：4 x M3x14；M3 AF5.5 x 2.4。14×14×4圆角承压耳；上开六角槽深2；先固定头部与罩壳，再安装前脸。
C30D PCB—05托架：4 x M3x16；M3 AF5.5 x 2.4。05局部承压台厚4；底部六角槽深2；先在工作台上安装PCB，再安装整只托架。PCB原孔约3.03，不扩大。
充电口法兰—罩壳：4 x M3x10；M3 AF5.5 x 2.4。内侧朝外敞开六角槽；拆壳后可扶住螺母。法兰保留原定位止口。
充电线缆鞍座—压盖：2 x M3x20；M3 AF5.5 x 2.4。压盖朝上六角槽；从鞍座下方装螺丝，先装线夹后装入整只充电口座；取消单颗顶丝。
Jetson—09托盘—头壳：4 x M2.5x20；M2.5 AF5 x 2。拆除原装底托及4颗短螺丝；两片Wi-Fi天线移至托盘前缘固定面；四柱无侧向切口，柱身直径7、顶部直径6、锥根直径13；M2.5x20贯穿固定。
05托架—电池仓—底板：4 x M3x14；M3 AF5.5 x 2.4。外伸耳厚4、槽深2、底厚2；螺母上露0.4；底部0.5垫片。
06 DC/DC托架—底板：4 x M3x10；M3 AF5.5 x 2.4。外伸耳厚4、槽深2、底厚2；螺母上露0.4；底部0.5垫片。
金属电机支架—底板：16 x M3x10（按金属板厚复核）；M3 AF5.5 x 2.4。金属支架自带安装耳；M3贯穿现有3.5孔，底板上方普通螺母及垫片，不对金属件重开六角孔。

4. 必要例外与实物核对
Jetson实际PCB孔直径2.75，采用M2.5x20及M2.5螺母，不扩大电路板孔。
N10原孔直径2.4，沿用M2x25及M2螺母。
屏幕商品图标注M3原生螺纹，D435原生安装螺纹：使用机器螺钉进入原生金属螺纹，不改采购件为通孔。允许旋入深度需实物确认。
前面板开关沿用原M12锁紧螺母。
电机/六角联轴器及轮毂采购件原有轴锁紧结构保持不变。
DC/DC无可信安装孔图，保留两条绑带槽；绑带不是自攻螺丝。
Jetson载板孔径2.75，通过M3杆会与PCB实体相交；采用M2.5x20。拆下可拆出厂塑料底托及4颗原螺丝后安装，保持载板及其固定器件的位置，两片天线以原始STEP几何移至托盘前缘，原线缆改为规划走线包络，源文件重复的左天线备选几何不重复装配，打印支柱直接到PCB底面124.0998；四柱均为连续无侧切柱体，柱身直径7、顶面直径6、顶部2mm渐缩、根部直径13；保留直径2.9通孔，不设置天线避让槽。头壳对应承压座直径12，底盘上盖让位孔直径13.2并设入口倒角。被拆部分保存在FCStd的隐藏参考组。M2.5螺母槽对边5.3、深2，名义螺母厚2。
D435：官方D400资料标注两处M3、最大旋入深度3。本版3mm安装耳可选M3x6加0.5垫片，名义旋入2.5；实物仍需确认贴合面。
屏幕：商品图标注M3，但未给允许旋入深度。本版7mm安装座，螺丝长度需按7mm+垫片厚度+实测允许啮合长度选定，不把未知深度当已确认。
所有结构螺丝按低头包络检查：M3头径5.5、高2；Jetson M2.5头径4.5、高2。购买头型超出该包络时需重新检查。金属电机支架板厚和原生连接件须按实物复核。
4处电池、4处DC/DC及16处金属电机支架各用一片0.5厚底部/承压垫片。其余连接按模型承压面直接贴合，额外加垫片需重算长度。
打印件中不再使用自攻螺丝、打印螺纹或热熔铜螺母盲孔。采购件自带可靠金属螺纹按原厂规格保留。
充电口取消单颗顶丝，使用带软衬垫的双螺丝线夹；接口外壳及线径仍是参考尺寸，插拔保持力需实物验证。

5. 装配顺序
先在工作台上安装托架PCB和螺母；把电池仓、软垫、电池及05托架组装到底板。安装DC/DC托架、金属电机支架。
头部先放颈座螺母并与罩壳连接；Jetson先拆出厂底托，使用M2.5贯穿PCB、打印托盘和头壳安装耳。拆下头部后可维护底部螺母；卸下前脸和贯穿螺丝后，Jetson托盘先抬高12mm，再向前抽出。
头部前脸装上屏幕和D435；从敞开的头壳放入四颗前后壳连接螺母，再安装前脸并从正面拧入M3x22。
充电口线夹先在壳外装配，再将整个充电口座从后方装入。罩壳从底部六处M3固定。拆卸顺序相反；抬起罩壳前先退出后置充电口模块并断开线缆。

整只DC/DC托架取出前，需要先拆后侧两组电机/车轮/金属支架，再向上提取；仅更换DC/DC模块可松开绑带，在托架不拆的情况下处理。不要强行从后电机之间拔出托架。

6. 验证与限制
静态实体干涉：0；接线预留冲突：0；计算错误：0。
紧固点几何检查：52/52；残留旧4.2铜螺母孔：0。
头部承压环及六角槽周围连续材料：True。
拆装路径：14/14。采用离散位姿，不是连续扫掠或线缆柔性仿真。
源STEP中部分形体存在无效拓扑。整体干涉使用保守包络，器件紧固点另按源实体局部检查。几何通过不等于强度认证。
未进行PETG静力、疲劳、热蠕变、夹紧扭矩或线夹抗拉试验。先打印4mm耳板/2mm槽试片，确认M3螺母能放入且不转，再整机打印。
全部10件仍按220×220平台校核。打印包中STL/STEP经刚性平移居中落地，未替代切片支撑与打印方向决策。

全部零件打印方向、支撑清理及耳板实心填充建议见FDM打印说明.txt。

参考资料
https://www.hubs.com/knowledge-base/enclosure-design-3d-printing-step-step-guide/
https://help.prusa3d.com/article/modeling-with-3d-printing-in-mind_164135
https://www.bossard.com/us-en/eshop/hex-nuts/hex-nuts-type-1/p/1983/
https://blog.prusa3d.com/practical-uses-of-color-change-in-prusaslicer_59563/
https://realsenseai.com/wp-content/uploads/2025/09/Intel-RealSense-D400-Series-Datasheet-October-2025.pdf
N10附送20211213尺寸图；屏幕/开关商品尺寸图；hardware下实际STEP模型。

最终天线固定座：4mm连续壁，与托盘一体成型；无四柱和悬空横跨。当前CAD为冻结几何工程，不包含从历史版本逐步生成的参数化建模脚本。
