Stella-CN/NavBot/hardware/design-v13/NavBot-V13-Print-Pack/参考图/CAD-charge-after.png

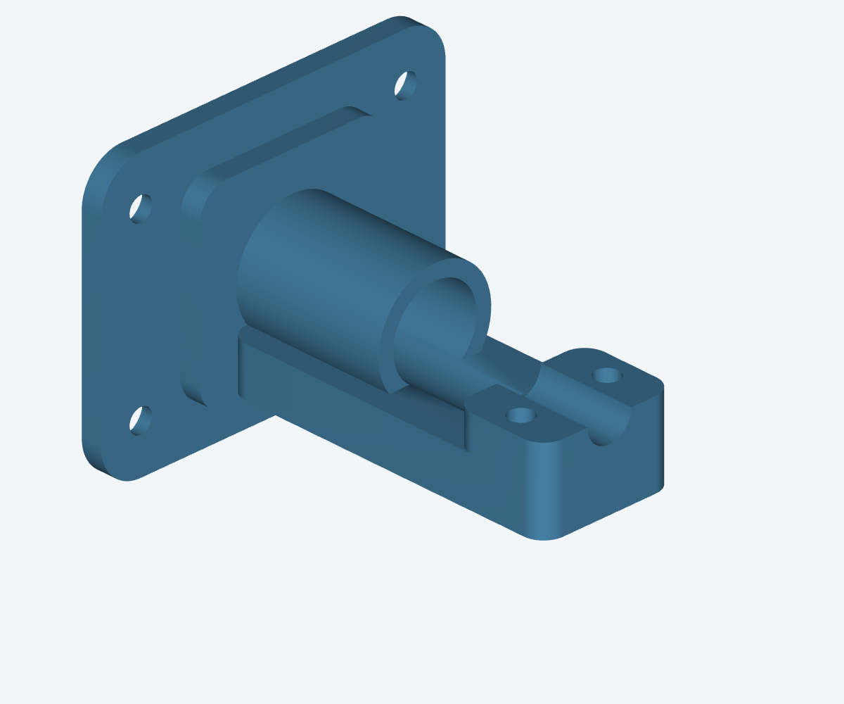
hardware/design-v13/NavBot-V13-Print-Pack/参考图/CAD-charge-after.png
