Stella-CN/NavBot/hardware/design-v13/NavBot-V13-Print-Pack/参考图/CAD-head-joints.png

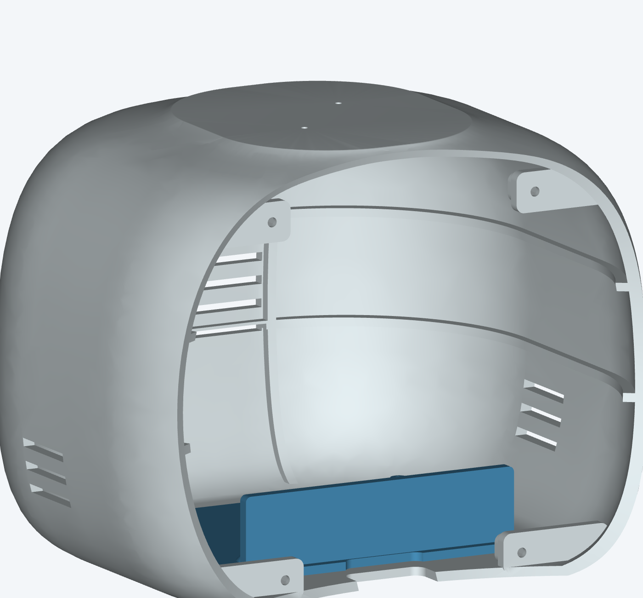
hardware/design-v13/NavBot-V13-Print-Pack/参考图/CAD-head-joints.png
